jbeneliezer/uv_tech/README.md

Senior Design:
Wearable uv detector with bluetooth and mobile app.
