jbeneliezer/uv_tech/UV/config/sl_bluetooth_config.h

#ifndef SL_BLUETOOTH_CONFIG_H
#define SL_BLUETOOTH_CONFIG_H
#if defined(SL_COMPONENT_CATALOG_PRESENT)
#include "sl_component_catalog.h"
#endif

// <<< Use Configuration Wizard in Context Menu >>>

// <h> Bluetooth Stack Configuration

#ifdef SL_CATALOG_BLUETOOTH_FEATURE_CONNECTION_PRESENT
#include "sl_bluetooth_connection_config.h"
#else
#define SL_BT_CONFIG_MAX_CONNECTIONS (0)
#endif

// Max number of connections reserved by user application and components
#define SL_BT_CONFIG_MAX_CONNECTIONS_SUM     (SL_BT_CONFIG_MAX_CONNECTIONS + SL_BT_COMPONENT_CONNECTIONS)

#ifdef SL_CATALOG_BLUETOOTH_FEATURE_ADVERTISER_PRESENT
#include "sl_bluetooth_advertiser_config.h"
#else
#define SL_BT_CONFIG_USER_ADVERTISERS (0)
#endif

#define SL_BT_CONFIG_MAX_ADVERTISERS     (SL_BT_CONFIG_USER_ADVERTISERS + SL_BT_COMPONENT_ADVERTISERS)

// <o SL_BT_CONFIG_MAX_SOFTWARE_TIMERS> Max number of software timers <0-16>
// <i> Default: 4
// <i> Define the number of software timers the application needs.  Each timer needs resources from the stack to be implemented. Increasing amount of soft timers may cause degraded performance in some use cases.
#define SL_BT_CONFIG_MAX_SOFTWARE_TIMERS     (4)

#ifdef SL_CATALOG_BLUETOOTH_FEATURE_SYNC_PRESENT
#include "sl_bluetooth_periodic_sync_config.h"
#else
#define SL_BT_CONFIG_MAX_PERIODIC_ADVERTISING_SYNC (0)
#endif

#ifdef SL_CATALOG_BLUETOOTH_FEATURE_L2CAP_PRESENT
#include "sl_bluetooth_l2cap_config.h"
#else
#define SL_BT_CONFIG_USER_L2CAP_COC_CHANNELS (0)
#endif

// <o SL_BT_CONFIG_BUFFER_SIZE> Buffer memory size for Bluetooth stack
// <i> Default: 3150
// <i> Define buffer memory size for running Bluetooth stack and buffering data over Bluetooth connections,
// <i> advertising and scanning. The default value is an estimation for achieving adequate throughput
// <i> and supporting multiple simultaneous connections. Consider increasing this value for
// <i> higher data throughput over connections, advertising or scanning long advertisement data.
#define SL_BT_CONFIG_BUFFER_SIZE    (3150)

// </h> End Bluetooth Stack Configuration

// <h> TX Power Levels

// <o SL_BT_CONFIG_MIN_TX_POWER> Minimum radiated TX power level in 0.1dBm unit
// <i> Default: -30 (-3 dBm)
// <i> Configure the minimum radiated TX power level for Bluetooth connections and DTM testing.
// <i> This configuration is used for power control on Bluetooth connections
// <i> if the LE Power Control feature is enabled.
// <i> When this configuration is passed into stack initialization, the stack
// <i> will select the closest value that the device supports.
// <i> API sl_bt_system_get_tx_power_setting() can be used to query the selected value.
#define SL_BT_CONFIG_MIN_TX_POWER     -30

// <o SL_BT_CONFIG_MAX_TX_POWER> Maximum radiated TX power level in 0.1dBm unit
// <i> Default: 80 (8 dBm)
// <i> Configure the maximum radiated TX power level for Bluetooth connections,
// <i> advertising, scanning and DTM testing.
// <i> When this configuration is passed into stack initialization, the stack
// <i> will select the closest value that the device supports.
// <i> API sl_bt_system_get_tx_power_setting() can be used to query the selected value.
#define SL_BT_CONFIG_MAX_TX_POWER     80

// </h> End TX Power Levels

// <h> RF Path

// <o SL_BT_CONFIG_RF_PATH_GAIN_TX> RF TX path gain in 0.1dBm unit
// <i> Default: 0
// <i> The Bluetooth stack takes TX RF path gain into account when adjusting transmitter
// <i> output power. Power radiated from the antenna then matches the application request.
// <i> For example, with radiated TX power set to +10 dBm and RF TX path
// <i> gain to -1 dBm, the transmitter output power will be set to +11 dBm.
#define SL_BT_CONFIG_RF_PATH_GAIN_TX     0

// <o SL_BT_CONFIG_RF_PATH_GAIN_RX> RF RX path gain in 0.1dBm unit
// <i> Default: 0
// <i> RX RF path gain is used to compensate the RSSI reports from the Bluetooth Stack.
#define SL_BT_CONFIG_RF_PATH_GAIN_RX     (0)

// </h> End RF Path

// <<< end of configuration section >>>

/**
 * By default, Bluetooth requires accurate LF clock for EM2. If the component
 * catalog presents, an inaccurate LF clock for EM2 can be used if the Bluetooth
 * connection, periodic advertising and periodic advertising synchronization
 * features are known to not present.
 */
#define BT_EM2_LFCLK_REQ_FLAG       0

#if defined(SL_COMPONENT_CATALOG_PRESENT)
#if !defined(SL_CATALOG_BLUETOOTH_FEATURE_CONNECTION_PRESENT)    \
  && !defined(SL_CATALOG_BLUETOOTH_FEATURE_PERIODIC_ADV_PRESENT) \
  && !defined(SL_CATALOG_BLUETOOTH_FEATURE_SYNC_PRESENT)
  #undef  BT_EM2_LFCLK_REQ_FLAG
  #define BT_EM2_LFCLK_REQ_FLAG     SL_BT_CONFIG_FLAG_INACCURATE_LFCLK_EM2
#endif
#endif // SL_COMPONENT_CATALOG_PRESENT

#ifdef SL_CATALOG_KERNEL_PRESENT
void sli_bt_rtos_ll_callback();
void sli_bt_rtos_stack_callback();
  #define SL_BT_CONFIG_FLAGS         (SL_BT_CONFIG_FLAG_RTOS | BT_EM2_LFCLK_REQ_FLAG)
  #define SL_BT_CONFIG_LL_CALLBACK    sli_bt_rtos_ll_callback
  #define SL_BT_CONFIG_STACK_CALLBACK sli_bt_rtos_stack_callback
#else
  #define SL_BT_CONFIG_FLAGS          (BT_EM2_LFCLK_REQ_FLAG)
  #define SL_BT_CONFIG_LL_CALLBACK    0
  #define SL_BT_CONFIG_STACK_CALLBACK 0
#endif // SL_CATALOG_KERNEL_PRESENT

#include "sl_bt_stack_config.h"

// Set PA configuration default values if RAIL PA Config component presents:
#ifdef SL_RAIL_UTIL_PA_CONFIG_HEADER
#include SL_RAIL_UTIL_PA_CONFIG_HEADER
#define BT_PA_CONFIG_STATE             SL_BT_RADIO_PA_CONFIG_ENABLED
#define BT_PA_SELECTION                SL_RAIL_UTIL_PA_SELECTION_2P4GHZ
#if SL_RAIL_UTIL_PA_VOLTAGE_MV == 3300
#define BT_PA_POWER_SUPPLY             SL_BT_RADIO_PA_INPUT_VBAT
#else
#define BT_PA_POWER_SUPPLY             SL_BT_RADIO_PA_INPUT_DCDC
#endif
#else
#define BT_PA_CONFIG_STATE             SL_BT_RADIO_PA_CONFIG_DISABLED
#define BT_PA_SELECTION                0
#define BT_PA_POWER_SUPPLY             0
#endif // SL_RAIL_UTIL_PA_CONFIG_HEADER

#define SL_BT_CONFIG_DEFAULT                                                   \
  {                                                                            \
    .config_flags = SL_BT_CONFIG_FLAGS,                                        \
    .bluetooth.max_connections = SL_BT_CONFIG_MAX_CONNECTIONS_SUM,             \
    .bluetooth.max_advertisers = SL_BT_CONFIG_MAX_ADVERTISERS,                 \
    .bluetooth.max_periodic_sync = SL_BT_CONFIG_MAX_PERIODIC_ADVERTISING_SYNC, \
    .bluetooth.max_l2cap_coc     = SL_BT_CONFIG_USER_L2CAP_COC_CHANNELS,       \
    .bluetooth.max_buffer_memory = SL_BT_CONFIG_BUFFER_SIZE,                   \
    .scheduler_callback = SL_BT_CONFIG_LL_CALLBACK,                            \
    .stack_schedule_callback = SL_BT_CONFIG_STACK_CALLBACK,                    \
    .gattdb = &gattdb,                                                         \
    .max_timers = SL_BT_CONFIG_MAX_SOFTWARE_TIMERS,                            \
    .rf.tx_gain = SL_BT_CONFIG_RF_PATH_GAIN_TX,                                \
    .rf.rx_gain = SL_BT_CONFIG_RF_PATH_GAIN_RX,                                \
    .rf.tx_min_power = SL_BT_CONFIG_MIN_TX_POWER,                              \
    .rf.tx_max_power = SL_BT_CONFIG_MAX_TX_POWER,                              \
    .pa.config_enable = BT_PA_CONFIG_STATE,                                    \
    .pa.input = BT_PA_POWER_SUPPLY,                                            \
    .pa.pa_mode = BT_PA_SELECTION,                                             \
  }

#endif // SL_BLUETOOTH_CONFIG_H
