jbeneliezer/uv_tech/UV/config/pin_config.h

#ifndef PIN_CONFIG_H
#define PIN_CONFIG_H

// $[CMU]
// [CMU]$

// $[LFXO]
// [LFXO]$

// $[PRS.ASYNCH0]
// [PRS.ASYNCH0]$

// $[PRS.ASYNCH1]
// [PRS.ASYNCH1]$

// $[PRS.ASYNCH2]
// [PRS.ASYNCH2]$

// $[PRS.ASYNCH3]
// [PRS.ASYNCH3]$

// $[PRS.ASYNCH4]
// [PRS.ASYNCH4]$

// $[PRS.ASYNCH5]
// [PRS.ASYNCH5]$

// $[PRS.ASYNCH6]
// [PRS.ASYNCH6]$

// $[PRS.ASYNCH7]
// [PRS.ASYNCH7]$

// $[PRS.ASYNCH8]
// [PRS.ASYNCH8]$

// $[PRS.ASYNCH9]
// [PRS.ASYNCH9]$

// $[PRS.ASYNCH10]
// [PRS.ASYNCH10]$

// $[PRS.ASYNCH11]
// [PRS.ASYNCH11]$

// $[PRS.SYNCH0]
// [PRS.SYNCH0]$

// $[PRS.SYNCH1]
// [PRS.SYNCH1]$

// $[PRS.SYNCH2]
// [PRS.SYNCH2]$

// $[PRS.SYNCH3]
// [PRS.SYNCH3]$

// $[GPIO]
// GPIO SWCLK on PA01
#define GPIO_SWCLK_PORT                          gpioPortA
#define GPIO_SWCLK_PIN                           1

// GPIO SWDIO on PA02
#define GPIO_SWDIO_PORT                          gpioPortA
#define GPIO_SWDIO_PIN                           2

// GPIO SWV on PA03
#define GPIO_SWV_PORT                            gpioPortA
#define GPIO_SWV_PIN                             3

// [GPIO]$

// $[TIMER0]
// [TIMER0]$

// $[TIMER1]
// [TIMER1]$

// $[TIMER2]
// [TIMER2]$

// $[TIMER3]
// [TIMER3]$

// $[TIMER4]
// [TIMER4]$

// $[USART0]
// [USART0]$

// $[USART1]
// [USART1]$

// $[I2C1]
// [I2C1]$

// $[PDM]
// [PDM]$

// $[LETIMER0]
// [LETIMER0]$

// $[IADC0]
// [IADC0]$

// $[I2C0]
// I2C0 SCL on PB01
#define I2C0_SCL_PORT                            gpioPortB
#define I2C0_SCL_PIN                             1

// I2C0 SDA on PB00
#define I2C0_SDA_PORT                            gpioPortB
#define I2C0_SDA_PIN                             0

// [I2C0]$

// $[EUART0]
// [EUART0]$

// $[PTI]
// [PTI]$

// $[MODEM]
// [MODEM]$

#endif // PIN_CONFIG_H
