jbeneliezer/uv_tech/UV/autogen/sl_event_handler.c

#include "sl_event_handler.h"

#include "em_chip.h"
#include "sl_device_init_nvic.h"
#include "sl_device_init_dcdc.h"
#include "sl_hfxo_manager.h"
#include "sl_device_init_hfxo.h"
#include "sl_device_init_lfrco.h"
#include "sl_device_init_clocks.h"
#include "sl_device_init_emu.h"
#include "pa_conversions_efr32.h"
#include "sl_sleeptimer.h"
#include "sl_bluetooth.h"
#include "sl_debug_swo.h"
#include "sl_emlib_gpio_simple_init.h"
#include "sl_mbedtls.h"
#include "sl_mpu.h"
#include "nvm3_default.h"
#include "sl_power_manager.h"

void sl_platform_init(void)
{
  CHIP_Init();
  sl_device_init_nvic();
  sl_device_init_dcdc();
  sl_hfxo_manager_init_hardware();
  sl_device_init_hfxo();
  sl_device_init_lfrco();
  sl_device_init_clocks();
  sl_device_init_emu();
  nvm3_initDefault();
  sl_power_manager_init();
}

void sl_driver_init(void)
{
  sl_debug_swo_init();
  sl_emlib_gpio_simple_init();
}

void sl_service_init(void)
{
  sl_sleeptimer_init();
  sl_hfxo_manager_init();
  sl_mbedtls_init();
  sl_mpu_disable_execute_from_ram();
}

void sl_stack_init(void)
{
  sl_rail_util_pa_init();
  sl_bt_init();
}

void sl_internal_app_init(void)
{
}

void sl_platform_process_action(void)
{
}

void sl_service_process_action(void)
{
}

void sl_stack_process_action(void)
{
  sl_bt_step();
}

void sl_internal_app_process_action(void)
{
}
