jbeneliezer/uv_tech/(commit log)

2021-10-14 polled sensor mode finished, still need to work out interrupt driven mode
2021-12-10 made some changes to si1132 driver
2021-12-10 Update si1132.c
    hopefully final commit for si1132 driver
2022-01-27 4 sensor init routine, reworked i2c, fixed si1132 init
    [app.c, app.h, i2c.c, i2c.h, pin_config.h, si1132.c]
2022-01-28 implemented si1132 calibration to init routine
2022-02-09 implemented ble gatt server. disabled hrfco
    UV data is sent every 0.5 seconds. the led is toggled on then off in the
    same intervals.
    hrfco has been disabled as ble wouldn't work with it enabled. the
    default behavior of having hrfco enabled via the project configurator,
    causes the radio peripheral to be clocked by the hrfco instead of hfxo.
    since the radio peripheral is expecting 38.4 mHz clock from hfxo, but is
    given a different value from hrfco, radio would not work.
    [application-crc.gbl, application.gbl, apploader-crc.gbl, apploader.gbl, full-crc.gbl, full.gbl]
2022-02-10 adjusted connection/advertising interval. implemented letimer, gpio int
    connection and advertising interval now 1000 ms to conserve power.
    gpio interrupt for button has been implemented (no other functionality).
    letimer interrupt implemented, set to interrupt every 1 second once a
    connection has been established. every 1 second, the interrupt will
    signal an event for the bt stack, which calls a function to notify
    the client of UV data.
2022-02-14 removed letimer/gpioint. bt stack soft timer used. uv data buffer.
    letimer is replaced with the bt stack soft timer because the soft timer
    is already integrated with the bt stack. gpioint no longer used, gpio
    interrupts have been implemented without that component. uv data is now
    buffered with a size of 3. on the 3rd data measurement, ble notification
    is sent with the data of the entire buffer.
    [app.c, app.h, i2c.c, sl_event_handler.c]
2022-02-15 bt stack soft timer replaced with sleeptimer. reorganization
    bt stack soft timer functions are deprecated, and replaced with
    sleeptimer. reorganized timer and gpio related code to their own files.
    [app.c, app.h, gpio.c, gpio.h, i2c.h, int_enum.h]
2022-02-15 gpio button debounce and hold detect
    gpio button debounced using timer. detection for a button press and a
    button hold implemented.
2022-02-16 advertising LED + advertising timeout
    advertising times out after 30 advertising events (around 60 seconds).
    LED blinks to indicate advertising. blinks occur 4 times a second, and
    LED stays on for (1/16) second every (4/16) seconds.
2022-04-19 hold to advertise. ble ext_signal fix
    holding the button now causes the device to go into advertising mode. if
    already connected, it will disconnect and advertise. fixed bl stack
    ext_signal conditionals.
    [app.c, app.h, timer.c]
2022-04-20 button press to reinitialize sensors
    on reinitializes when ble activity is not active (device in "OFF"
    state)
2022-04-23 changed push button pin
    port c and d can not wake up mcu from deep sleep. changed from PC01 to
    PB02
    [application-crc.gbl, application.gbl, full-crc.gbl, full.gbl]
